bmellink/Quiz/Schematics/2ndGeneration.pdf

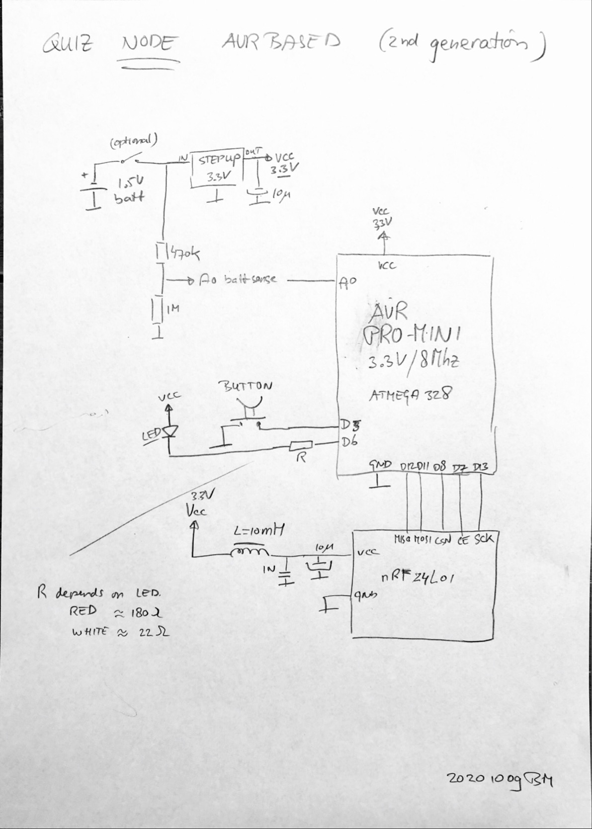
[picture p13: page 1]
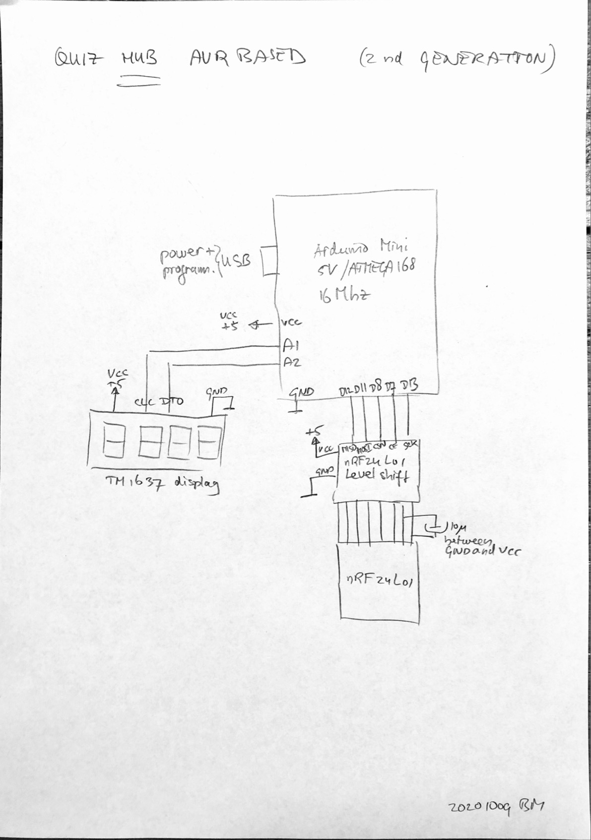
[picture p14: page 2]
