bmellink/Quiz/Schematics/3rdGeneration.pdf

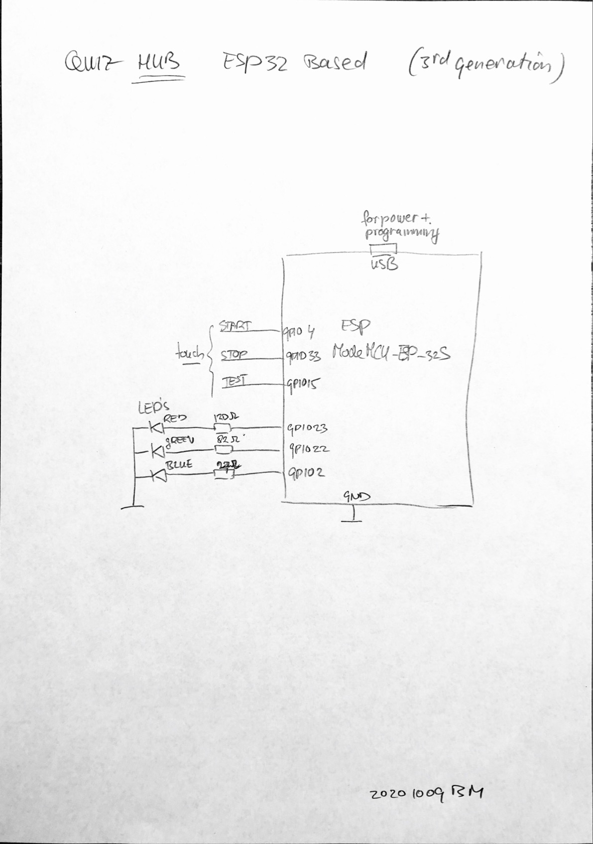
[picture p15: page 1]
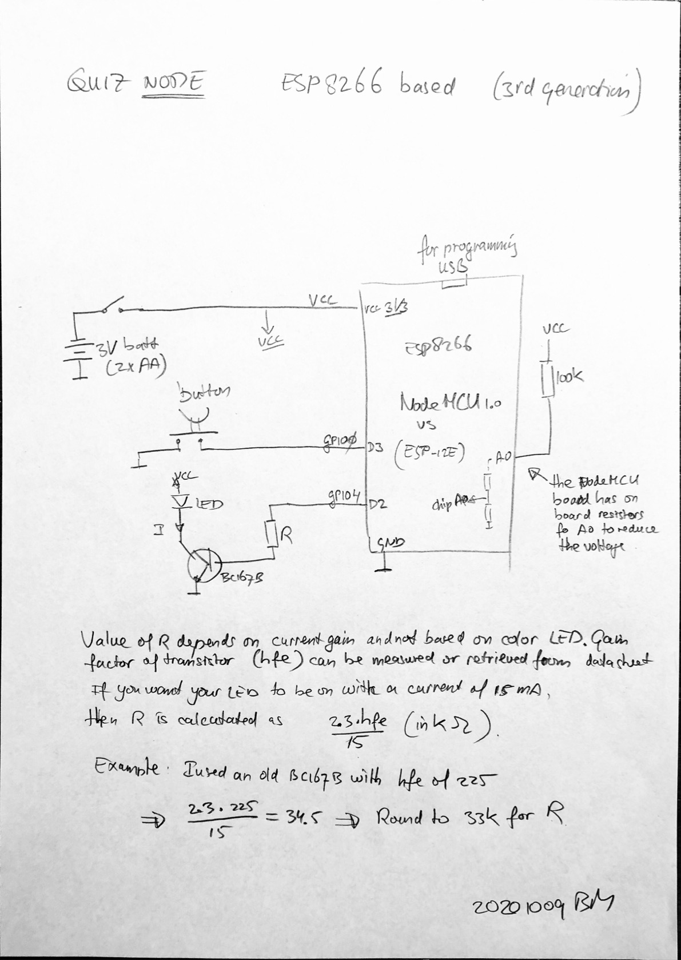
[picture p16: page 2]
