bmellink/Quiz/(threads)

Thread 1 (2022-03-24):

Waiting for server

quocanhcgd, 2022-03-24:
My system use esp32 hub and 8266 for node. When i check node and hub connect, all work ok. But when i use address quiz.local or ip of hub, the browser only show “Waiting for server”. How can i fix it?

ddhi94, 2022-03-29:
> My system use esp32 hub and 8266 for node. When i check node and hub connect, all work ok. But when i use address quiz.local or ip of hub, the browser only show “Waiting for server”. How can i fix it?

I also have the same situation
Please help me!
